robboworld/laboratory/eagle/gerber/USB ADDITIONAL HOLES.jpg

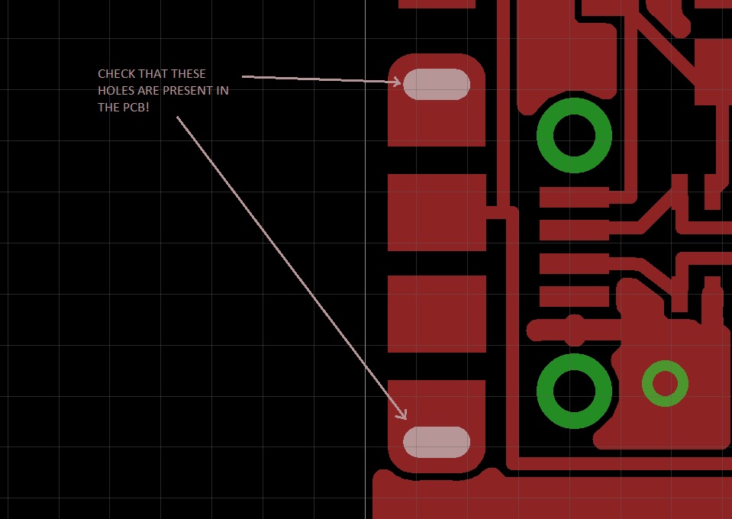
eagle/gerber/USB ADDITIONAL HOLES.jpg
