robboworld/laboratory/eagle/gerber/USB CONNECTOR HOLE DIMENSIONS.jpg

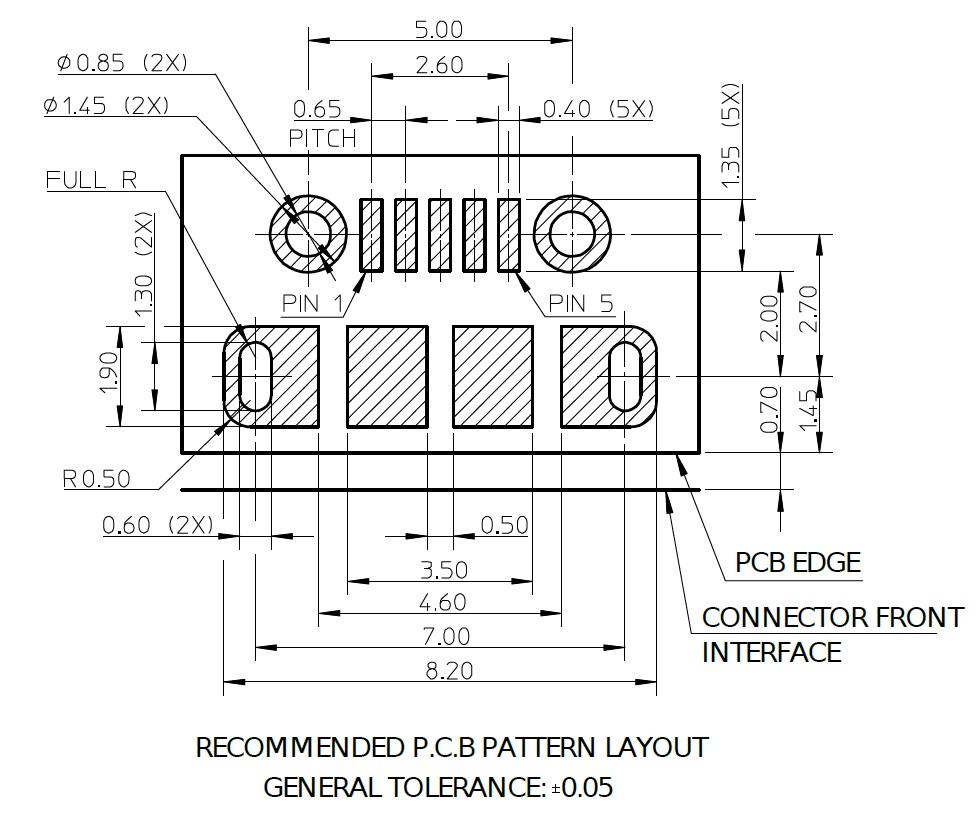
eagle/gerber/USB CONNECTOR HOLE DIMENSIONS.jpg
