robboworld/laboratory/eagle/Lab.brd

## EAGLE design eagle/Lab.brd (2016-09-03)

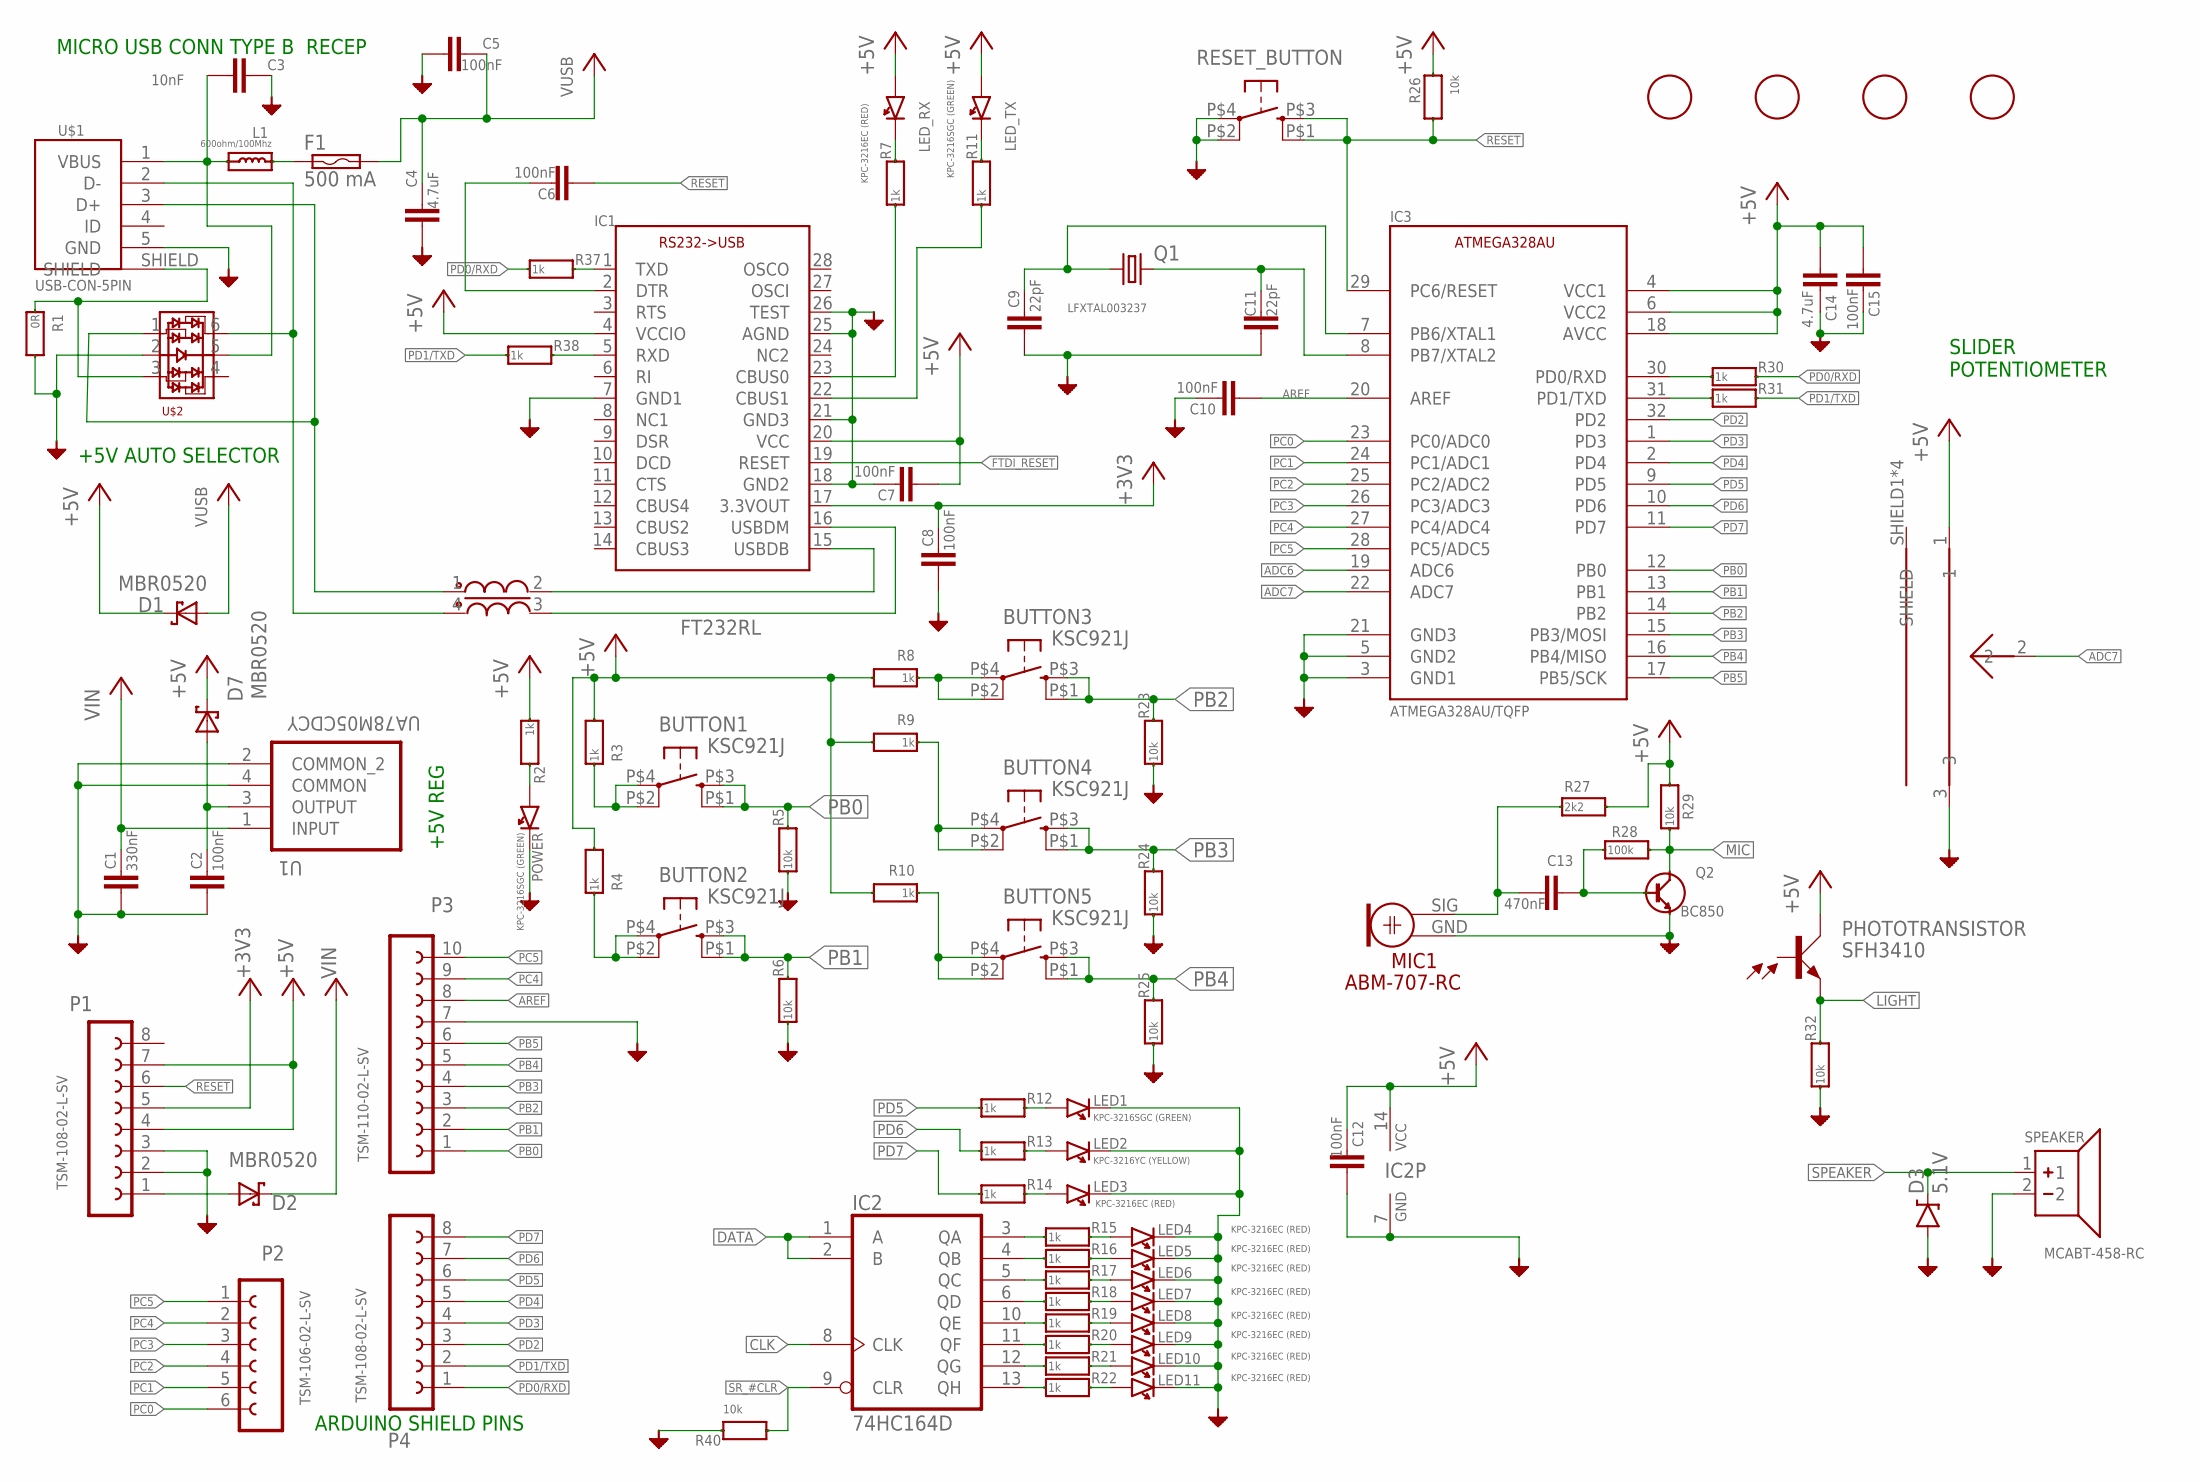
[picture p3: schematic Lab.sch, sheet 1]

Parts:
BUTTON1, BUTTON2, BUTTON3, BUTTON4, BUTTON5: KSC921J; TACT_SWITCH_4_PIN; MPN KSC921J LFS
C1: 330nF; C0805; MPN 08053C334KAT2A
C2, C5, C6, C7, C8, C10, C12, C15: 100nF; C0805; MPN 08055C104KAT2A
C3: 10nF; C0805; MPN MC0805B103K500CT
C4, C14: 4.7uF; C0805; MPN 0805X475K250CT
C9, C11: 22pF; C0805; MPN CC0805JRNPO9BN220
C13: 470nF; C0805; MPN MC0805F474Z250CT
D1, D2, D7: MBR0520; SOD123; MPN MBR0520L
D3: 5.1V; SOD-323; MPN MM3Z5V1T1G
F1: 500 mA; PT1206; MPN NANOSMDC050F/13.2-2
IC1: FT232RL; SSOP28; MPN FT232RL-REEL
IC2: 74HC164D; SO14; MPN 74HC164D
IC3: ATMEGA328AU/TQFP; TQFP32-08; MPN ATMEGA328P-AU
L1: 600ohm/100Mhz; R0603; MPN 742792651
LED1: KPC-3216SGC (GREEN); LED3216_PAC; MPN KPC-3216SGC
LED2: KPC-3216YC (YELLOW); LED3216_PAC; MPN KPC-3216YC
LED3, LED4, LED5, LED6, LED7, LED8, LED9, LED10, LED11: KPC-3216EC (RED); LED3216_PAC; MPN KPC-3216EC
LED_RX: KPC-3216EC (RED); LED3216_PAC; MPN KPC-3216EC
LED_TX: KPC-3216SGC (GREEN); LED3216_PAC; MPN KPC-3216SGC
MIC1: ABM-707-RC; MPN ABM-707-RC
P1, P4: TSM-108-02-L-SV; FE08; MPN 2212S-08SG-85
P2: TSM-106-02-L-SV; FE06; MPN 2212S-06SG-85
P3: TSM-110-02-L-SV; FE10; MPN 2212S-10SG-85
PHOTOTRANSISTOR: SFH3410SMD; SFH3410; MPN SFH3410-Z
POWER: KPC-3216SGC (GREEN); LED3216_PAC; MPN KPC-3216SGC
Q1: LFXTAL003237; SM49; MPN LFXTAL003237
Q2: BC850; MY_SOT23; MPN BC850C,215
R1: 0R; R0805; MPN MC01W08050R
R2, R3, R4, R7, R8, R9, R10, R11, R12, R13, R14, R15, R16, R17, R18, R19, R20, R21, R22, R30, R31, R37, R38: 1k; R0805; MPN CRCW08051K00FKTA
R5, R6, R23, R24, R25, R26, R29, R32, R40: 10k; R0805; MPN RC0805FR-0710KL
R27: 2k2; R0805; MPN RC0805FR-072K2L.
R28: 100k; R0805; MPN RC0805FR-07100KL
RESET_BUTTON: KSC921J; TACT_SWITCH_4_PIN; MPN KSC921J LFS
SLIDER_RESISTOR: PTA4543; MPN PTA4543-2015DPB103
SPEAKER: MCABT-458-RC; SMD_SPK_PAC; MPN MCABT-458-RC
U1: UA78M05CDCY; SOT230P700X180-4N
U$1: USB-CON-5PIN; USB-MICRO-MOLEX-105017-0001_V2; MPN 105017-0001
U$2: PRTR5V0U4Y; SOT363; MPN PRTR5V0U4Y,125
U$3, U$4, U$5, U$6: FIDUCIAL; FIDUCIAL_1MM
USB_FILTER: SRF3216A; MPN SRF3216A-900Y

Connections:
+3V3: C8.1, IC1.17 (3.3VOUT), P1.5
+5V: C7.2, C12.2, C14.2, C15.2, D1.1 (K), D7.1 (K), IC1.4 (VCCIO), IC1.20 (VCC), IC2.14 (VCC), IC3.4 (VCC1), IC3.6 (VCC2), IC3.18 (AVCC), LED_RX.1, LED_TX.1, P1.4, P1.7, PHOTOTRANSISTOR.COLLECTOR, R2.1, R3.2, R4.2, R8.2, R9.2, R10.2, R26.2, R27.2, R29.2, SLIDER_RESISTOR.1; also elsewhere on the board
ADC6: IC3.19 (ADC6)
ADC7: IC3.22 (ADC7), SLIDER_RESISTOR.2
AREF: C10.2, IC3.20 (AREF), P3.8
CLK: IC2.8 (CLK); also elsewhere on the board
DATA: IC2.1 (A), IC2.2 (B); also elsewhere on the board
FTDI_RESET: IC1.19 (RESET); also elsewhere on the board
GND: C1.2, C2.2, C3.1, C4.2, C5.2, C7.1, C8.2, C9.2, C10.1, C11.2, C12.1, C14.1, C15.1, D3.A, IC1.7 (GND1), IC1.18 (GND2), IC1.21 (GND3), IC1.25 (AGND), IC1.26 (TEST), IC2.7 (GND), IC3.3 (GND1), IC3.5 (GND2), IC3.21 (GND3), LED1.2, LED2.2, LED3.2, LED4.2, LED5.2, LED6.2, LED7.2, LED8.2, LED9.2, LED10.2, LED11.2, MIC1.GND (2), P1.2, P1.3, P3.7, POWER.2, Q2.2, R1.2, R5.1, R6.1, R23.1, R24.1, R25.1, R32.1, R40.2, RESET_BUTTON.P$2 (2), RESET_BUTTON.P$4 (1), SLIDER_RESISTOR.3, SPEAKER.2, U1.2 (COMMON_2), U1.4 (COMMON), U$1.5 (GND), U$2.2; also elsewhere on the board
LIGHT: PHOTOTRANSISTOR.EMITTER, R32.2; also elsewhere on the board
MIC: Q2.3, R28.2, R29.1; also elsewhere on the board
unnamed: C11.1, IC3.8 (PB7/XTAL2), Q1.2
unnamed: C9.1, IC3.7 (PB6/XTAL1), Q1.1
unnamed: LED5.1, R16.2
unnamed: LED3.1, R14.2
unnamed: LED2.1, R13.2
unnamed: LED1.1, R12.2
unnamed: LED4.1, R15.2
unnamed: LED6.1, R17.2
unnamed: LED7.1, R18.2
unnamed: LED8.1, R19.2
unnamed: LED9.1, R20.2
unnamed: D2.2 (A), P1.1
unnamed: LED10.1, R21.2
unnamed: IC1.23 (CBUS0), R7.1
unnamed: C6.1, IC1.2 (DTR)
unnamed: POWER.1, R2.2
unnamed: IC1.15 (USBDB), USB_FILTER.2
unnamed: IC1.16 (USBDM), USB_FILTER.3
unnamed: LED11.1, R22.2
unnamed: IC3.30 (PD0/RXD), R30.1
unnamed: IC2.3 (QA), R15.1
unnamed: IC2.4 (QB), R16.1
unnamed: IC2.5 (QC), R17.1
unnamed: LED_RX.2, R7.2
unnamed: LED_TX.2, R11.2
unnamed: IC1.22 (CBUS1), R11.1
unnamed: U$1.3 (D+), U$2.1, USB_FILTER.1
unnamed: IC3.31 (PD1/TXD), R31.1
unnamed: BUTTON1.P$2 (2), BUTTON1.P$4 (1), R3.1
unnamed: BUTTON2.P$2 (2), BUTTON2.P$4 (1), R4.1
unnamed: U$1.2 (D-), U$2.6, USB_FILTER.4
unnamed: BUTTON4.P$2 (2), BUTTON4.P$4 (1), R9.1
unnamed: BUTTON5.P$2 (2), BUTTON5.P$4 (1), R10.1
unnamed: BUTTON3.P$2 (2), BUTTON3.P$4 (1), R8.1
unnamed: F1.1A (1), F1.1B (1), L1.1
unnamed: IC1.5 (RXD), R38.2
unnamed: IC1.1 (TXD), R37.2
unnamed: C2.1, D7.2 (A), U1.3 (OUTPUT)
unnamed: IC2.6 (QD), R18.1
unnamed: IC2.10 (QE), R19.1
unnamed: IC2.11 (QF), R20.1
unnamed: IC2.12 (QG), R21.1
unnamed: IC2.13 (QH), R22.1
unnamed: C13.1, Q2.1, R28.1
unnamed: C13.2, MIC1.SIG (1), R27.1
unnamed: C3.2, L1.2, U$1.1 (VBUS), U$2.5
PB0: BUTTON1.P$1 (4), BUTTON1.P$3 (3), IC3.12 (PB0), P3.1, R5.2
PB1: BUTTON2.P$1 (4), BUTTON2.P$3 (3), IC3.13 (PB1), P3.2, R6.2
PB2: BUTTON3.P$1 (4), BUTTON3.P$3 (3), IC3.14 (PB2), P3.3, R23.2
PB3: BUTTON4.P$1 (4), BUTTON4.P$3 (3), IC3.15 (PB3/MOSI), P3.4, R24.2
PB4: BUTTON5.P$1 (4), BUTTON5.P$3 (3), IC3.16 (PB4/MISO), P3.5, R25.2
PB5: IC3.17 (PB5/SCK), P3.6; also elsewhere on the board
PC0: IC3.23 (PC0/ADC0), P2.6; also elsewhere on the board
PC1: IC3.24 (PC1/ADC1), P2.5; also elsewhere on the board
PC2: IC3.25 (PC2/ADC2), P2.4
PC3: IC3.26 (PC3/ADC3), P2.3; also elsewhere on the board
PC4: IC3.27 (PC4/ADC4), P2.2, P3.9; also elsewhere on the board
PC5: IC3.28 (PC5/ADC5), P2.1, P3.10; also elsewhere on the board
PD0/RXD: P4.1, R30.2, R37.1
PD1/TXD: P4.2, R31.2, R38.1
PD2: IC3.32 (PD2), P4.3; also elsewhere on the board
PD3: IC3.1 (PD3), P4.4; also elsewhere on the board
PD4: IC3.2 (PD4), P4.5; also elsewhere on the board
PD5: IC3.9 (PD5), P4.6, R12.1
PD6: IC3.10 (PD6), P4.7, R13.1
PD7: IC3.11 (PD7), P4.8, R14.1
RESET: C6.2, IC3.29 (PC6/RESET), P1.6, R26.1, RESET_BUTTON.P$1 (4), RESET_BUTTON.P$3 (3)
SHIELD1: R1.1, U$1.SHIELD, U$2.3
SPEAKER: D3.C, SPEAKER.1; also elsewhere on the board
SR_#CLR: IC2.9 (CLR), R40.1; also elsewhere on the board
USB_VCC: C4.1, C5.1, D1.2 (A), F1.2A (2), F1.2B (2)
VIN: C1.1, D2.1 (K), U1.1 (INPUT)

Notes on the sheet:
SLIDER POTENTIOMETER
+5V AUTO SELECTOR
+5V REG
ARDUINO SHIELD PINS
MICRO USB CONN TYPE B RECEP

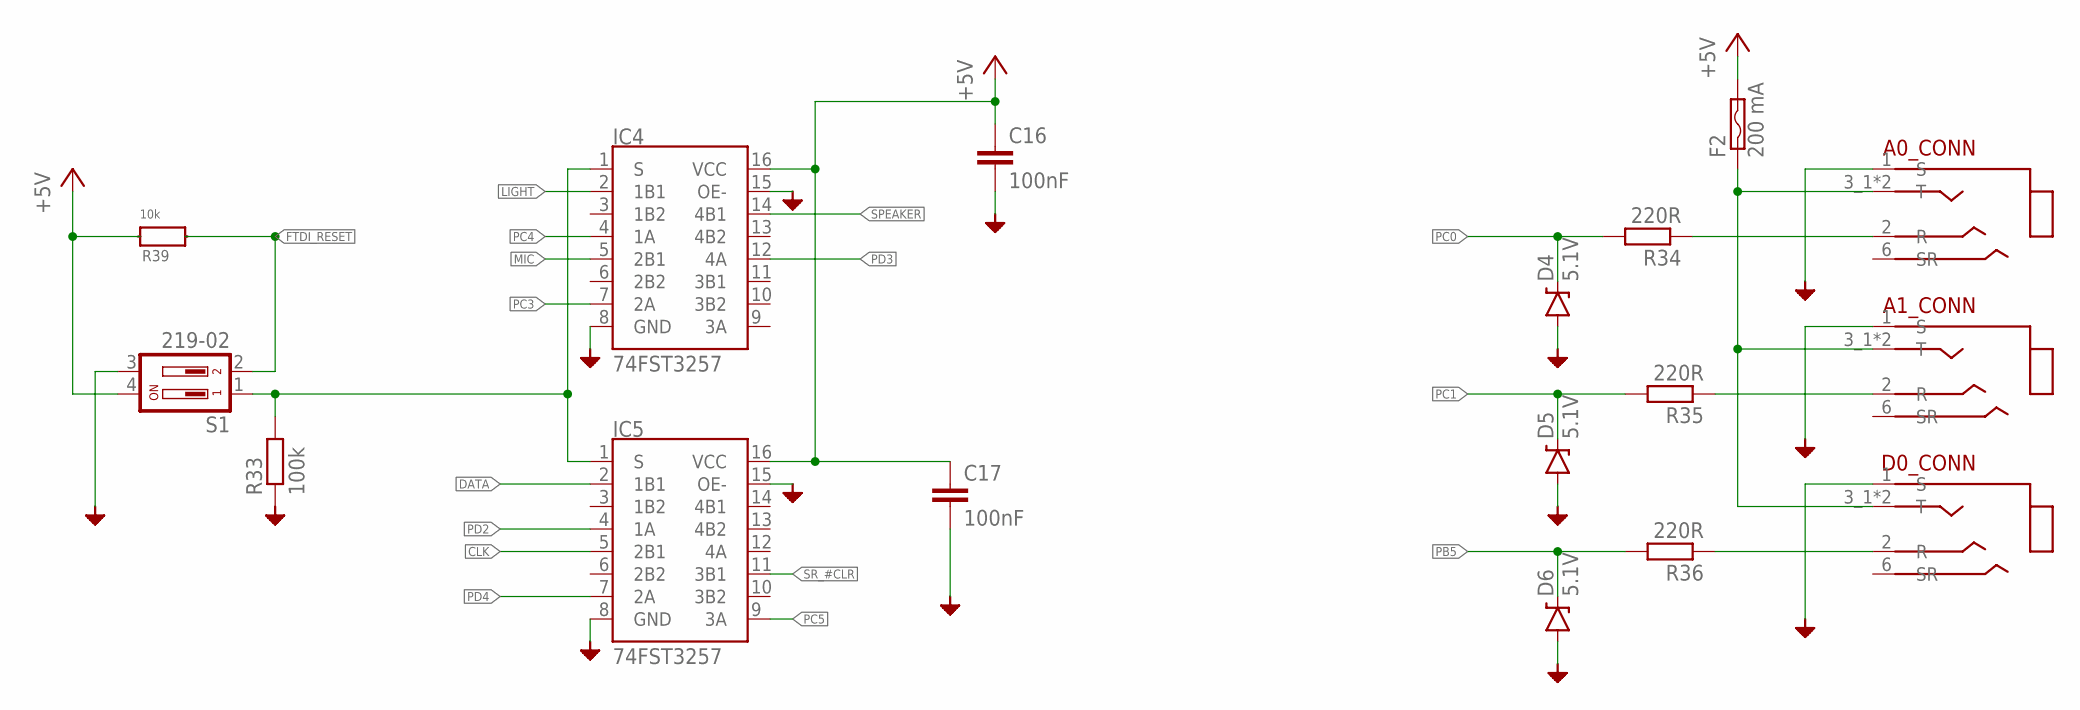
[picture p4: schematic Lab.sch, sheet 2]

Parts:
A0_CONN, A1_CONN: FC68125; MPN FC68125
C16, C17: 100nF; C0805; MPN 08055C104KAT2A
D0_CONN: FC68125; MPN FC68125
D4, D5, D6: 5.1V; SOD-323; MPN MM3Z5V1T1G
F2: 200 mA; PT1206; MPN NANOSMDC020F-2
IC4, IC5: 74FST3257; SO16; MPN 74FST3257DR2G
R33: 100k; R0805; MPN RC0805FR-07100KL
R34, R35, R36: 220R; M0805; MPN MCWR08X2200FTL
R39: 10k; R0805; MPN RC0805FR-0710KL
S1: 219-02; CTS-219-02; MPN MCEMR-02-T

Connections:
+5V: C16.1, C17.1, F2.2A (2), F2.2B (2), IC4.16 (VCC), IC5.16 (VCC), R39.2, S1.4; also elsewhere on the board
+5V_FUSED: A0_CONN.3_1 (T), A0_CONN.3_2 (T), A1_CONN.3_1 (T), A1_CONN.3_2 (T), D0_CONN.3_1 (T), D0_CONN.3_2 (T), F2.1A (1), F2.1B (1)
CLK: IC5.5 (2B1); also elsewhere on the board
DATA: IC5.2 (1B1); also elsewhere on the board
FTDI_RESET: R39.1, S1.2; also elsewhere on the board
GND: A0_CONN.1 (S), A1_CONN.1 (S), C16.2, C17.2, D0_CONN.1 (S), D4.A, D5.A, D6.A, IC4.8 (GND), IC4.15 (OE-), IC5.8 (GND), IC5.15 (OE-), R33.1, S1.3; also elsewhere on the board
LIGHT: IC4.2 (1B1); also elsewhere on the board
MIC: IC4.5 (2B1); also elsewhere on the board
unnamed: IC4.1 (S), IC5.1 (S), R33.2, S1.1
unnamed: A1_CONN.2 (R), R35.1
unnamed: A0_CONN.2 (R), R34.1
unnamed: D0_CONN.2 (R), R36.1
PB5: D6.C, R36.2; also elsewhere on the board
PC0: D4.C, R34.2; also elsewhere on the board
PC1: D5.C, R35.2; also elsewhere on the board
PC3: IC4.7 (2A); also elsewhere on the board
PC4: IC4.4 (1A); also elsewhere on the board
PC5: IC5.9 (3A); also elsewhere on the board
PD2: IC5.4 (1A); also elsewhere on the board
PD3: IC4.12 (4A); also elsewhere on the board
PD4: IC5.7 (2A); also elsewhere on the board
SPEAKER: IC4.14 (4B1); also elsewhere on the board
SR_#CLR: IC5.11 (3B1); also elsewhere on the board

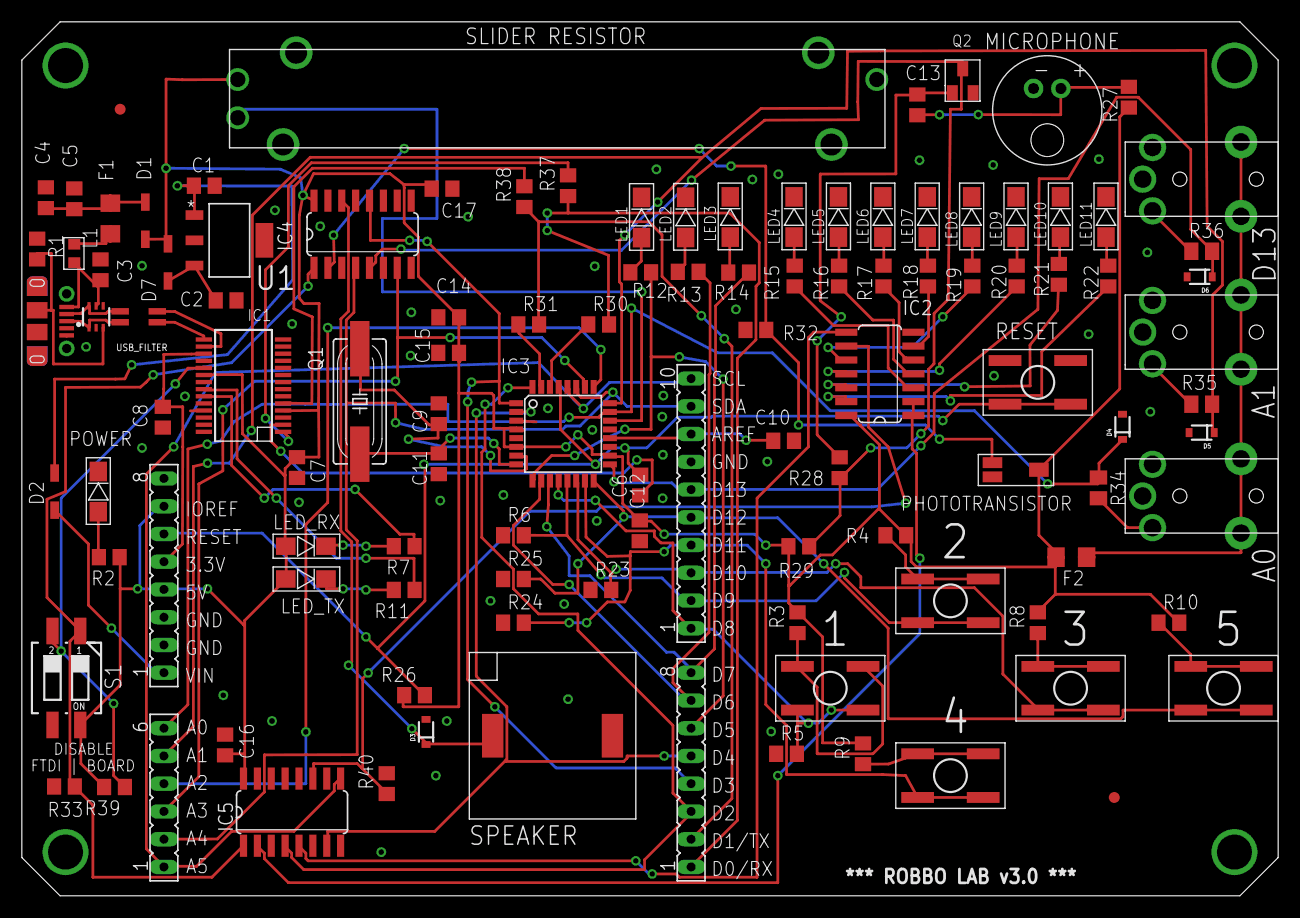
[picture p5: board Lab.brd from above]

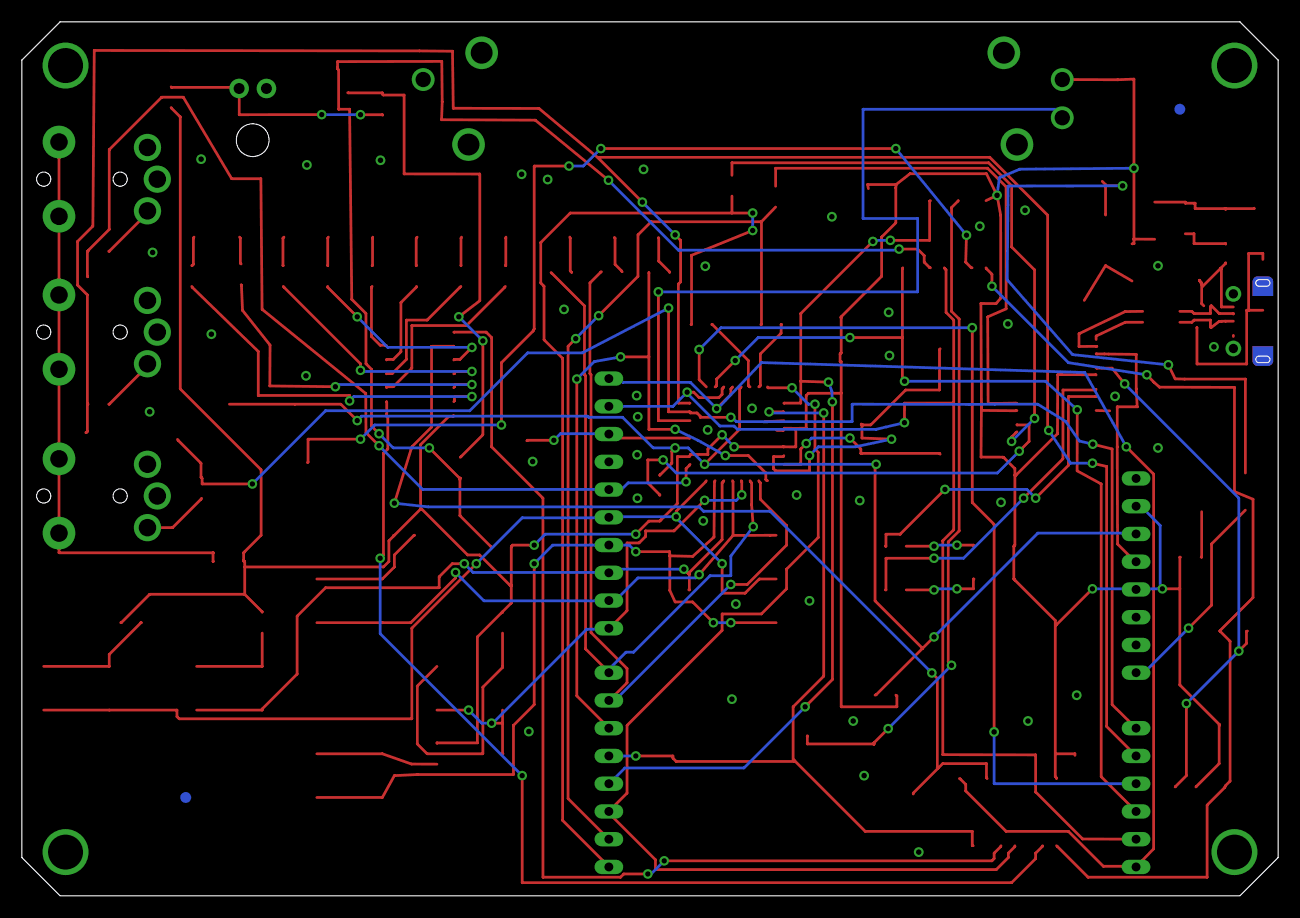
[picture p6: board Lab.brd from below]

Board: 2 copper layers, 115.0 x 80.0 mm, 114 parts (2 on the bottom side), 87 nets.
